michaelpaulkorthals/py_irc/images/hdmi_2.0_4k_matrix_4x4.jpg

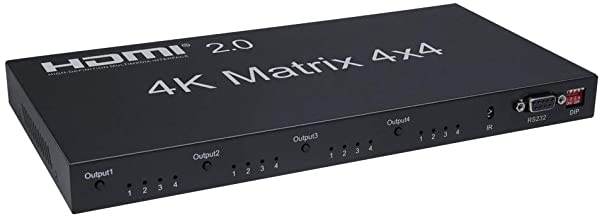
images/hdmi_2.0_4k_matrix_4x4.jpg
