michaelpaulkorthals/py_irc/(threads)

Thread 2 (2021-08-08):

Infrared sending collision in "irc_api.py"

michaelpaulkorthals, 2021-08-08:
If sending two (or more ) infrared commands in parallel, the a runtime error is reported in the log book.

michaelpaulkorthals, 2021-08-08:
It is possible to add and use a "threading.RLock()" object to the code of the IR sender. This will queue the commands received from multiple threads one after the other.

michaelpaulkorthals, 2021-08-08:
I have implemented and tested the update on my development system and the productive website.

The update is working without any problems. I can now shutdown the Amplifier 1 and switch on Amplifier 2 in my home theater application by a single touch without any collisions in the IR signal sequences.

michaelpaulkorthals, 2021-08-08:
I updated the file "irc_api.py".

Done.

Closed 2021-08-08.
