michaelpaulkorthals/py_irc/irc_circuit/irc_circuit.pdf

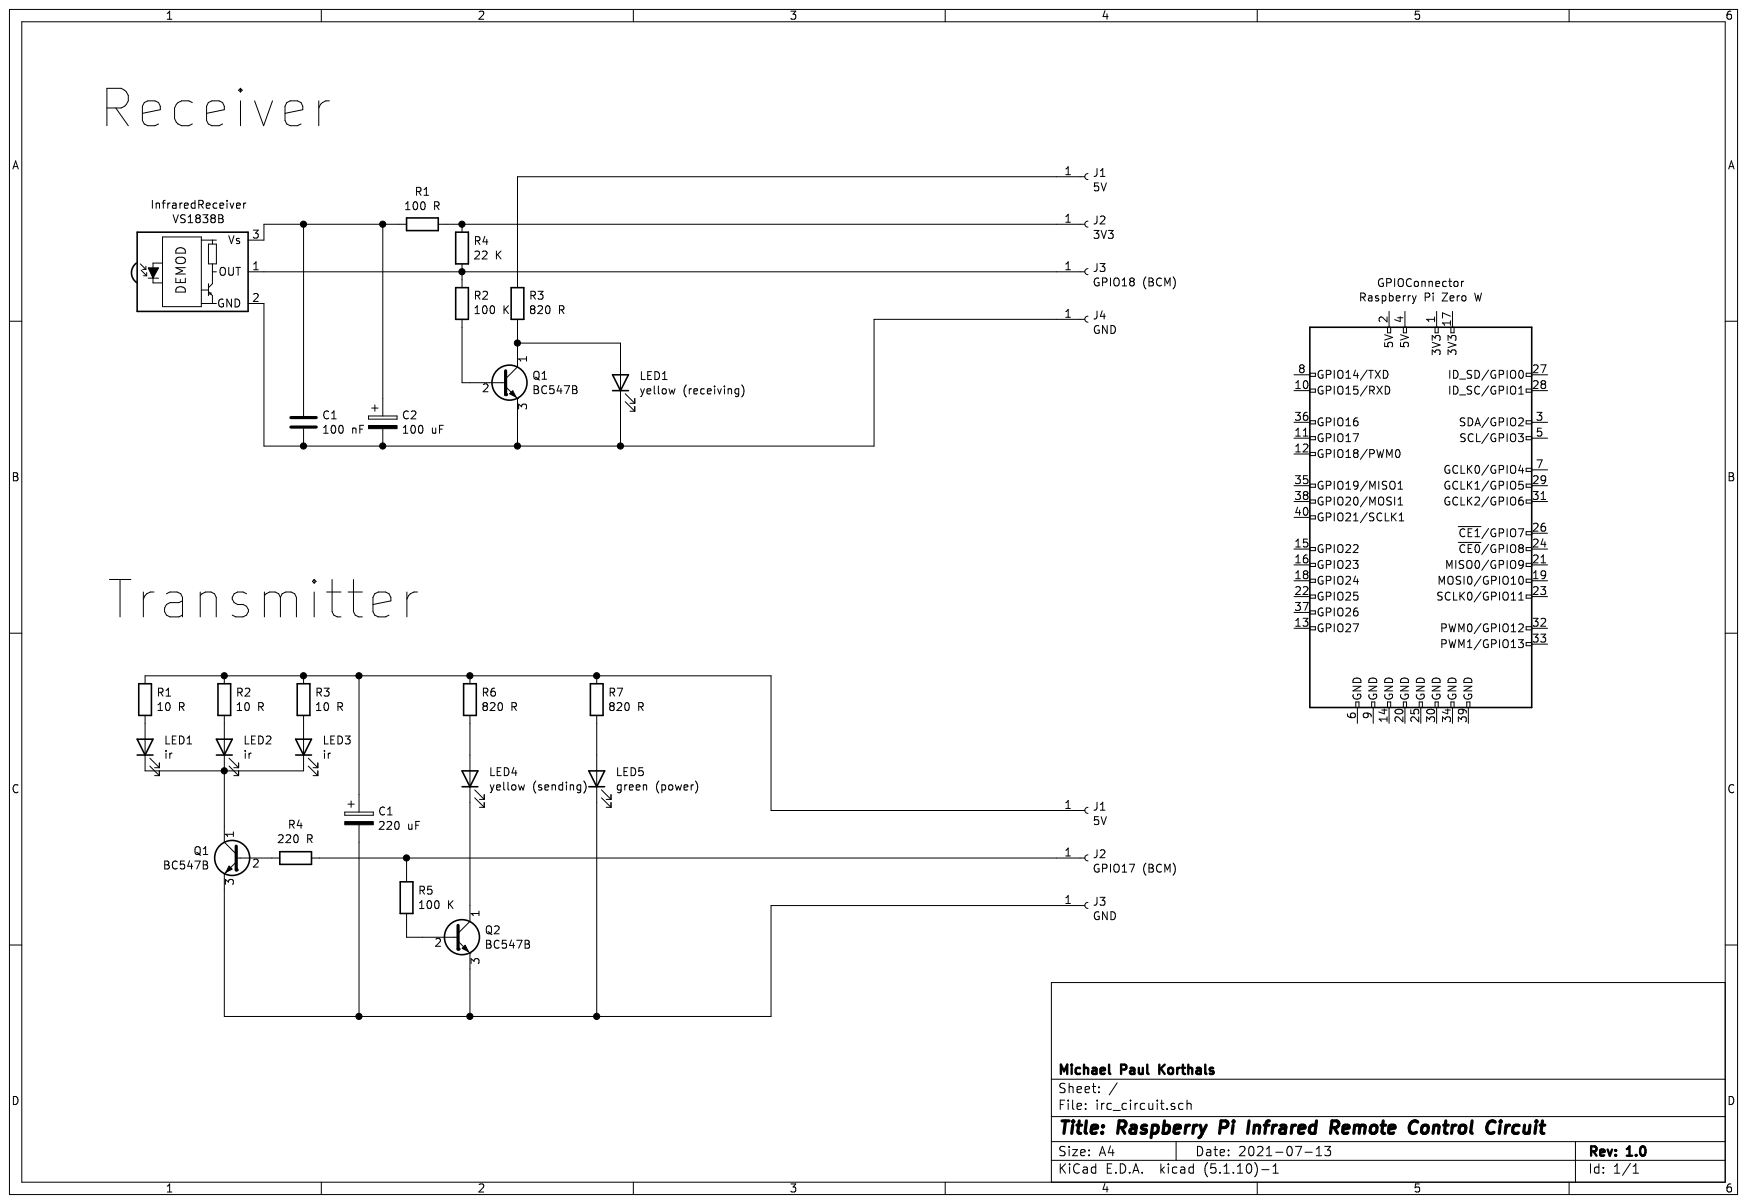
[picture p5: page 1]
