michaelpaulkorthals/py_irc/(commit log)

2021-07-13 Create test.txt
    Raspberry Pi Infrared Remote Control Circuit
2021-08-08 Bug in the IR sender routine solved.
    [irc_api.py]
