michaelpaulkorthals/py_irc/(notices)

Notices in the files:
irc_learn.py:
it under the terms of the GNU General Public License as published by
